FBIopeningUPP/aerix-20x20/README.md

# **AERIX**

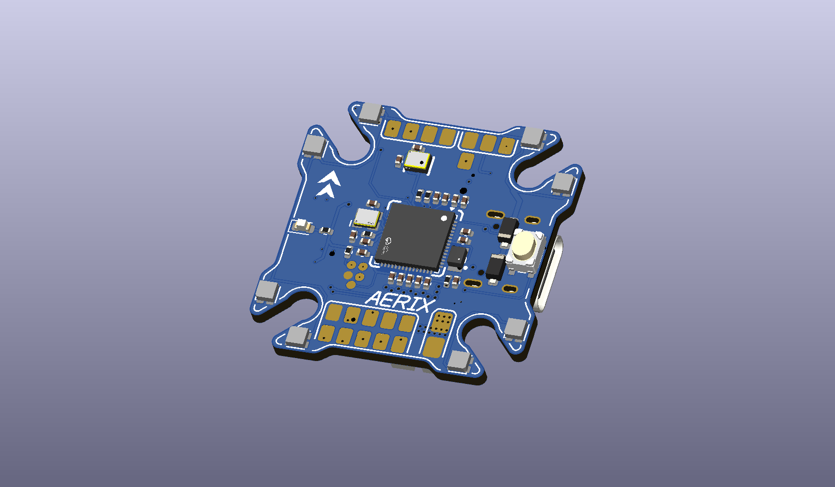
[picture p1: images/aerix-board-render.png]
AERIX 3D render


i wanted to design my own flight controller for fpv racing, so i made aerix. it fits a 20×20 mm stack and runs on an rp2354a with an icm-40609-d gyro.

i went with solder pads for the esc, receiver and vtx to keep the board small. the 8 rgb leds around the corners are there because they look cool af.

## front and back

| front | back |
| :---: | :---: |
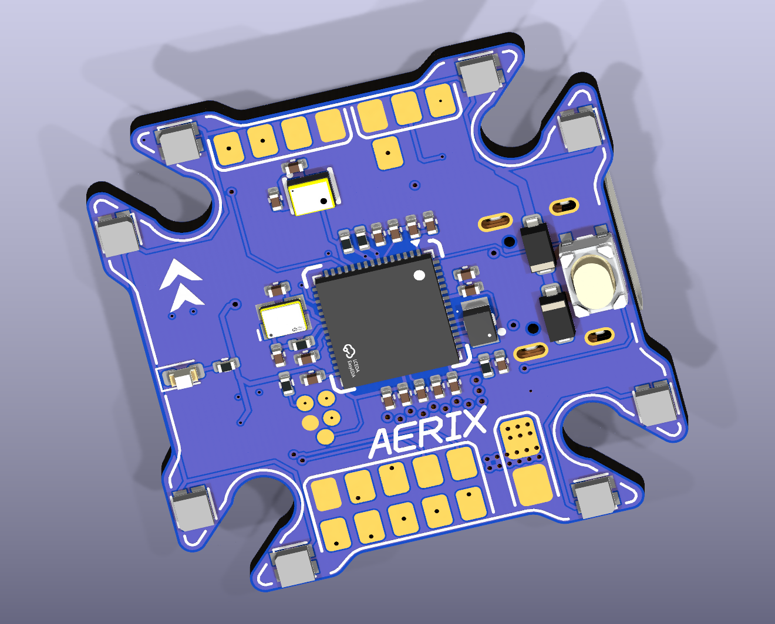
[picture p2: images/aerix-front-render.png]
Front of AERIX
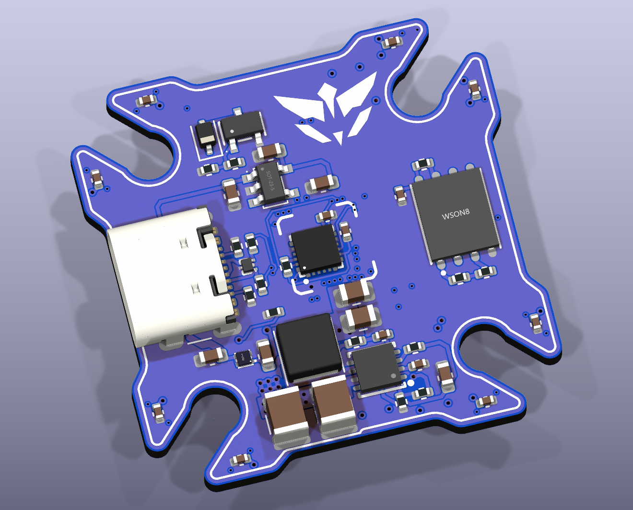
[picture p3: images/aerix-back-render.png]
Back of AERIX
|  |  |

## copper layers

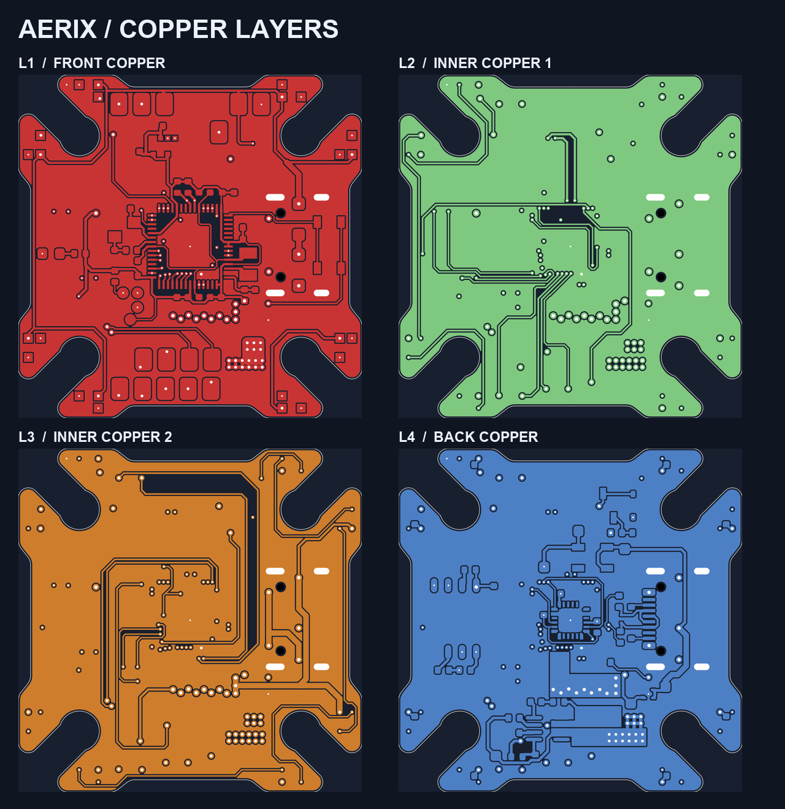
[picture p4: images/layers/aerix-copper-layers.png]
All four AERIX copper layers


<details>
<summary>see each layer up close</summary>

| front copper | inner copper 1 |
| :---: | :---: |
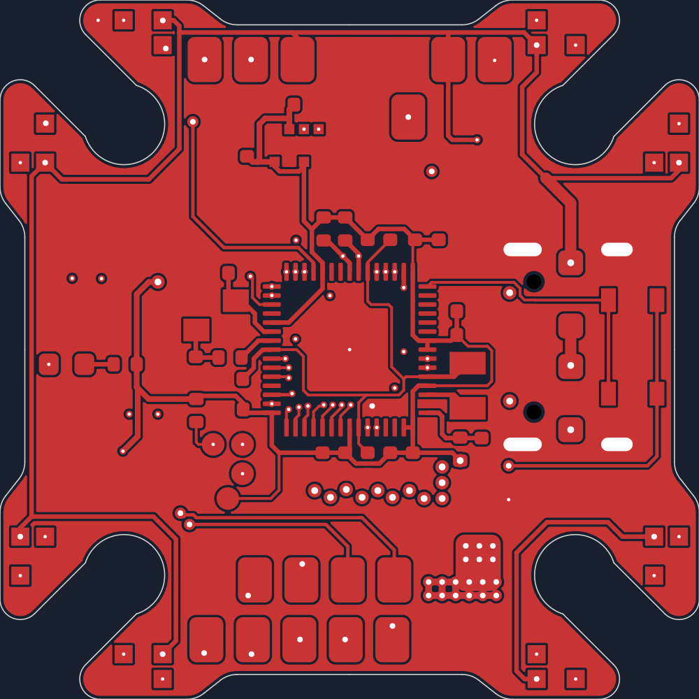
[picture p5: images/layers/01-front-copper.png]
Front copper
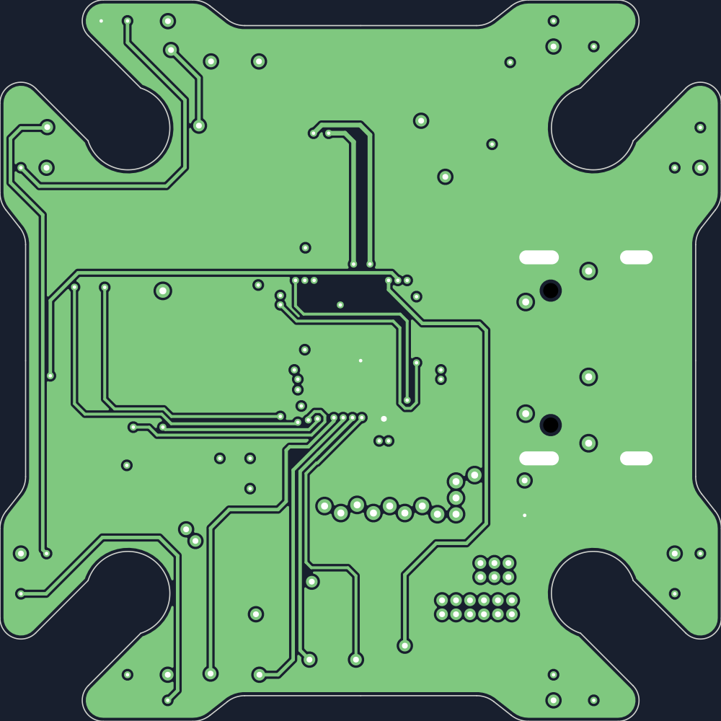
[picture p6: images/layers/02-inner-copper-1.png]
Inner copper 1
|  |  |

| inner copper 2 | back copper |
| :---: | :---: |
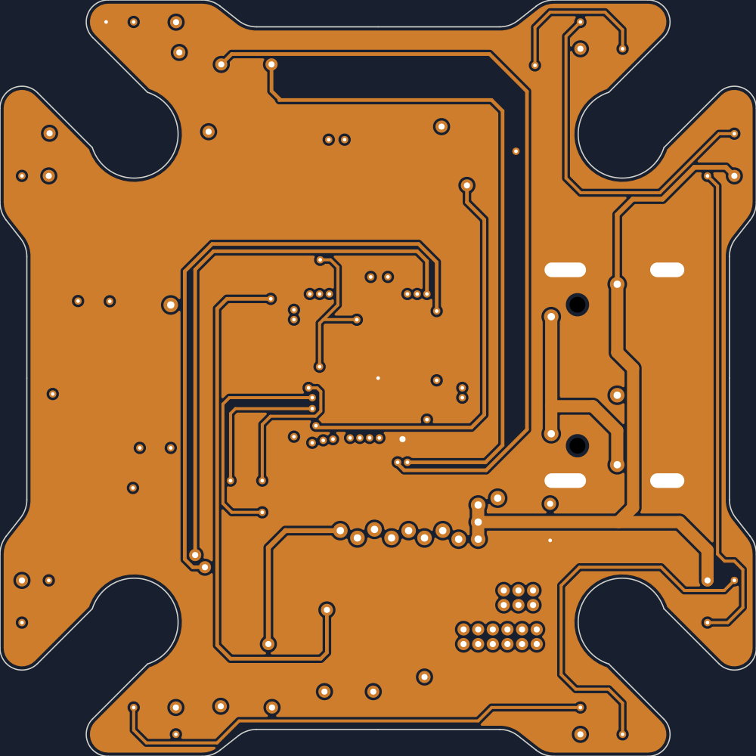
[picture p7: images/layers/03-inner-copper-2.png]
Inner copper 2
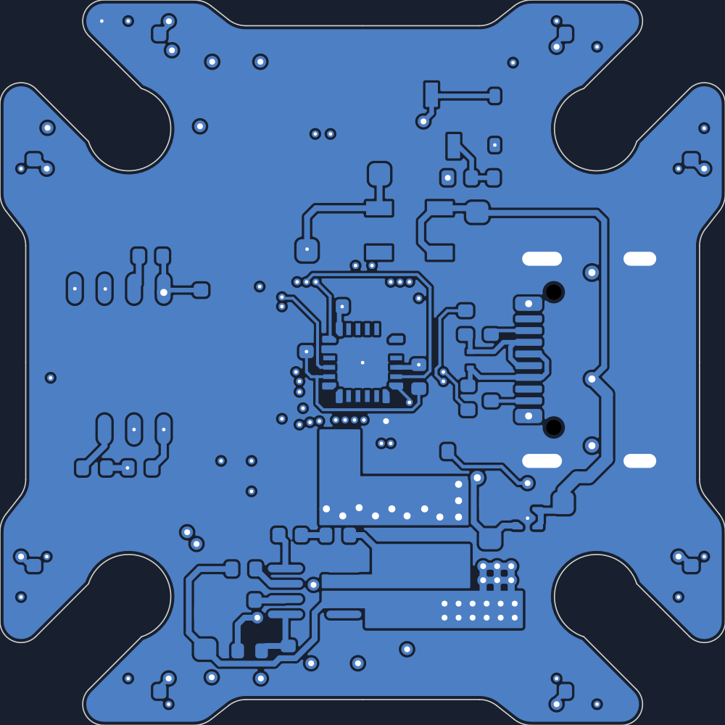
[picture p8: images/layers/04-back-copper.png]
Back copper
|  |  |

</details>

## files

- [kicad project](hardware/fc-v1/fc-v1.kicad_pro)
- [gerbers and drill files](hardware/production/fc-v1/fc-v1.zip)
- [interactive BOM](hardware/production/fc-v1/ibom.html) (download and open in a browser)

## bill of materials

| ref | part | qty |
| --- | --- | ---: |
| U1 | RP2354A microcontroller | 1 |
| U3 | ICM-40609-D gyro | 1 |
| U4 | W25Q128JVPIQTR flash | 1 |
| U5 | MP9943GQ-Z 5 V regulator | 1 |
| J1 | USB4105-GF-A USB-C port | 1 |
| LED10–LED17 | WS2812B-2020-V6 RGB LEDs | 8 |
| U2 | DPS368 barometer (optional) | 1 |

[full parts list with quantities and supplier links](hardware/production/fc-v1/aerix-bom.csv)
