FBIopeningUPP/aerix-20x20/hardware/production/fc-v1/aerix-bom.csv

Part | Quantity | References | Footprint | LCSC Part # | Supplier link | Notes
Capacitor, 4.7uF | 3 | C1, C11, C12 | 0402 |  | https://www.digikey.in/en/products/result?keywords=Capacitor%2C%204.7uF%200402
Capacitor, 0.1uF | 11 | C10, C13, C14, C2, C3, C4, C5, C6, C7, C8, C9 | 0402 |  | https://www.digikey.in/en/products/result?keywords=Capacitor%2C%200.1uF%200402
Capacitor, 10pF | 2 | C15, C16 | 0402 |  | https://www.digikey.in/en/products/result?keywords=Capacitor%2C%2010pF%200402
Capacitor, 2.2uF | 1 | C17 | 0603 |  | https://www.digikey.in/en/products/result?keywords=Capacitor%2C%202.2uF%200603
Capacitor, 100nF | 6 | C18, C20, C21, C22, C23, C24 | 0402 |  | https://www.digikey.in/en/products/result?keywords=Capacitor%2C%20100nF%200402
Capacitor, 10nF | 1 | C19 | 0402 |  | https://www.digikey.in/en/products/result?keywords=Capacitor%2C%2010nF%200402
Capacitor, 10uF 50V X7R | 2 | C25, C26 | 1210 |  | https://www.digikey.in/en/products/result?keywords=Capacitor%2C%2010uF%2050V%20X7R%201210
Capacitor, 1uF 50V | 1 | C27 | 0603 |  | https://www.digikey.in/en/products/result?keywords=Capacitor%2C%201uF%2050V%200603
Capacitor, 22uF 10V X7R | 2 | C28, C29 | 0805 |  | https://www.digikey.in/en/products/result?keywords=Capacitor%2C%2022uF%2010V%20X7R%200805
Capacitor, 2.2uF 10V | 4 | C30, C31, C32, C33 | 0603 |  | https://www.digikey.in/en/products/result?keywords=Capacitor%2C%202.2uF%2010V%200603
Capacitor, 100nF 16V X7R | 8 | C42, C43, C44, C45, C46, C47, C48, C49 | 0402 |  | https://www.digikey.in/en/products/result?keywords=Capacitor%2C%20100nF%2016V%20X7R%200402
PMEG4010CEH,115 | 2 | D1, D2 | D_SOD-123F |  | https://www.digikey.in/en/products/result?keywords=PMEG4010CEH%2C115
BAT54WS | 1 | D4 | D_SOD-323 |  | https://www.digikey.in/en/products/result?keywords=BAT54WS
TPD2EUSB30ADRTR | 1 | D5 | SOT-9X3-3_L1.0-W0.8-P0.35-LS1.0-BR | C94934 | https://www.lcsc.com/product-detail/C94934.html
USB4105-GF-A | 1 | J1 | USB_C_Receptacle_GCT_USB4105-xx-A_16P_TopMnt_Horizontal |  | https://www.digikey.in/en/products/result?keywords=USB4105-GF-A
3.3 uH inductor (AOTA-B201610S3R3-101-T) | 1 | L1 | IND-SMD_L2.0-W1.6_AOTA-B201610S3R3-101-T | C42411119 | https://www.lcsc.com/product-detail/C42411119.html
10 uH, 1 A inductor (4 x 4 x 1.8 mm) | 1 | L3 | L_APV_ANR4020 |  | https://www.digikey.in/en/products/result
LTST-C191KRKT | 1 | LED1 | 0603 |  | https://www.digikey.in/en/products/result?keywords=LTST-C191KRKT
WS2812B-2020-V6 | 8 | LED10, LED11, LED12, LED13, LED14, LED15, LED16, LED17 | LED-SMD_4P-L2.2-W2.0-P1.00_WS2815C-2020-4P | C52917434 | https://www.lcsc.com/product-detail/C52917434.html
2N7002BK,215 | 1 | Q1 | SOT-23-3_L3.0-W1.7-P0.95-LS2.9-BR | C282405 | https://www.lcsc.com/product-detail/C282405.html
Resistor, 33 ohm | 1 | R1 | 0402 |  | https://www.digikey.in/en/products/result?keywords=Resistor%2C%2033%20ohm%200402
Resistor, 100R | 1 | R19 | 0402 |  | https://www.digikey.in/en/products/result?keywords=Resistor%2C%20100R%200402
Resistor, 1k | 2 | R2, R3 | 0402 |  | https://www.digikey.in/en/products/result?keywords=Resistor%2C%201k%200402
Resistor, 100k | 1 | R20 | 0402 |  | https://www.digikey.in/en/products/result?keywords=Resistor%2C%20100k%200402
Resistor, 5.1k 1% | 2 | R21, R22 | 0402 |  | https://www.digikey.in/en/products/result?keywords=Resistor%2C%205.1k%201%25%200402
Resistor, 27R | 2 | R23, R24 | 0402 |  | https://www.digikey.in/en/products/result?keywords=Resistor%2C%2027R%200402
Resistor, 10k | 5 | R25, R28, R29, R30, R31 | 0402 |  | https://www.digikey.in/en/products/result?keywords=Resistor%2C%2010k%200402
Resistor, 330R | 1 | R32 | 0402 |  | https://www.digikey.in/en/products/result?keywords=Resistor%2C%20330R%200402
Resistor, 4.7k | 2 | R4, R5 | 0402 |  | https://www.digikey.in/en/products/result?keywords=Resistor%2C%204.7k%200402
Resistor, 1M | 1 | R6 | 0402 |  | https://www.digikey.in/en/products/result?keywords=Resistor%2C%201M%200402
Resistor, 52.3k 1% | 1 | R7 | 0402 |  | https://www.digikey.in/en/products/result?keywords=Resistor%2C%2052.3k%201%25%200402
Resistor, 10k 1% | 1 | R8 | 0402 |  | https://www.digikey.in/en/products/result?keywords=Resistor%2C%2010k%201%25%200402
Resistor, 20R | 1 | R9 | 0402 |  | https://www.digikey.in/en/products/result?keywords=Resistor%2C%2020R%200402
Momentary SMD push button (4.2 x 3.2 x 2.5 mm) | 1 | SW1 | Push_SMD_4.2x3.2mm_h2.5mm_Beige |  | https://www.digikey.in/en/products/result
RP2354A | 1 | U1 | QFN-60-1EP_7x7mm_P0.4mm_EP3.4x3.4mm |  | https://www.digikey.in/en/products/result?keywords=RP2354A
DPS368XTSA1 | 1 | U2 | LGA-8_L2.5-W2.0-P0.65-TR_DPS368 | C3232508 | https://www.lcsc.com/product-detail/C3232508.html | Optional barometer
ICM-40609-D | 1 | U3 | LGA-24_L3.0-W3.0-P0.40-TL | C5360621 | https://www.lcsc.com/product-detail/C5360621.html
W25Q128JVPIQTR | 1 | U4 | WSON-8_L6.0-W5.0-P1.27-BL-EP | C190862 | https://www.lcsc.com/product-detail/C190862.html
MP9943GQ-Z | 1 | U5 | QFN-8_L3.0-W3.0-P0.65-BL | C477821 | https://www.lcsc.com/product-detail/C477821.html
TLV75533PDQNR | 1 | U6 | X2SON-4_L1.0-W1.0-P0.65-TL-EP | C2861882 | https://www.lcsc.com/product-detail/C2861882.html
LP5907MFX-3.3/NOPB | 1 | U7 | SOT-23-5_L3.0-W1.7-P0.95-LS2.8-BR | C80670 | https://www.lcsc.com/product-detail/C80670.html
ABM10-167-12.000MHZ-T3 | 1 | X1 | CRYSTAL-SMD_4P-L2.5-W2.0-BL | C1985295 | https://www.lcsc.com/product-detail/C1985295.html
