FBIopeningUPP/aerix-20x20/hardware/production/fc-v1/bom.csv

Designator | Footprint | Quantity | Value | LCSC Part #
C1, C11, C12 | 0402 | 3 | 4.7uF
C10, C13, C14, C2, C3, C4, C5, C6, C7, C8, C9 | 0402 | 11 | 0.1uF
C15, C16 | 0402 | 2 | 10pF
C17 | 0603 | 1 | 2.2uF
C18, C20, C21, C22, C23, C24 | 0402 | 6 | 100nF
C19 | 0402 | 1 | 10nF
C25, C26 | 1210 | 2 | 10uF 50V X7R
C27 | 0603 | 1 | 1uF 50V
C28, C29 | 0805 | 2 | 22uF 10V X7R
C30, C31, C32, C33 | 0603 | 4 | 2.2uF 10V
C42, C43, C44, C45, C46, C47, C48, C49 | 0402 | 8 | 100nF 16V X7R
D1, D2 | D_SOD-123F | 2 | PMEG4010CEH,115
D4 | D_SOD-323 | 1 | BAT54WS
D5 | SOT-9X3-3_L1.0-W0.8-P0.35-LS1.0-BR | 1 | TPD2EUSB30ADRTR | C94934
J1 | USB_C_Receptacle_GCT_USB4105-xx-A_16P_TopMnt_Horizontal | 1 | USB4105-GF-A
L1 | IND-SMD_L2.0-W1.6_AOTA-B201610S3R3-101-T | 1 | 3.3uH | C42411119
L3 | L_APV_ANR4020 | 1 | 10uH_1.0A_4018
LED1 | 0603 | 1 | LTST-C191KRKT
LED10, LED11, LED12, LED13, LED14, LED15, LED16, LED17 | LED-SMD_4P-L2.2-W2.0-P1.00_WS2815C-2020-4P | 8 | WS2812B-2020-V6 | C52917434
Q1 | SOT-23-3_L3.0-W1.7-P0.95-LS2.9-BR | 1 | 2N7002BK,215 | C282405
R1 | 0402 | 1 | 33
R19 | 0402 | 1 | 100R
R2, R3 | 0402 | 2 | 1k
R20 | 0402 | 1 | 100k
R21, R22 | 0402 | 2 | 5.1k 1%
R23, R24 | 0402 | 2 | 27R
R25, R28, R29, R30, R31 | 0402 | 5 | 10k
R32 | 0402 | 1 | 330R
R4, R5 | 0402 | 2 | 4.7k
R6 | 0402 | 1 | 1M
R7 | 0402 | 1 | 52.3k 1%
R8 | 0402 | 1 | 10k 1%
R9 | 0402 | 1 | 20R
SW1 | Push_SMD_4.2x3.2mm_h2.5mm_Beige | 1 | Momentary Tactile Button - Biege
U1 | QFN-60-1EP_7x7mm_P0.4mm_EP3.4x3.4mm | 1 | RP2354A
U2 | LGA-8_L2.5-W2.0-P0.65-TR_DPS368 | 1 | DPS368XTSA1 | C3232508
U3 | LGA-24_L3.0-W3.0-P0.40-TL | 1 | ICM-40609-D | C5360621
U4 | WSON-8_L6.0-W5.0-P1.27-BL-EP | 1 | W25Q128JVPIQTR | C190862
U5 | QFN-8_L3.0-W3.0-P0.65-BL | 1 | MP9943GQ-Z | C477821
U6 | X2SON-4_L1.0-W1.0-P0.65-TL-EP | 1 | TLV75533PDQNR | C2861882
U7 | SOT-23-5_L3.0-W1.7-P0.95-LS2.8-BR | 1 | LP5907MFX-3.3/NOPB | C80670
X1 | CRYSTAL-SMD_4P-L2.5-W2.0-BL | 1 | ABM10-167-12.000MHZ-T3 | C1985295
