FBIopeningUPP/aerix-20x20/hardware/fc-v1/fc-v1.kicad_pcb

## KiCad design hardware/fc-v1/fc-v1.kicad_pcb (2026-11-10)

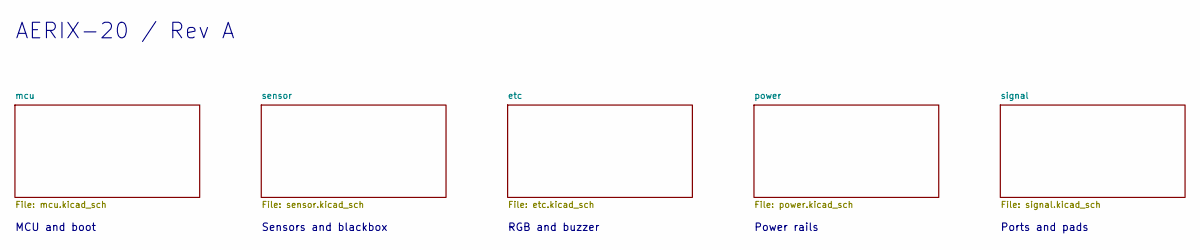
[picture p9: schematic fc-v1.kicad_sch, AERIX-20 - Flight controller]

Notes on the sheet:
Ports and pads
Sensors and blackbox
RGB and buzzer
AERIX-20 / Rev A
MCU and boot
Power rails

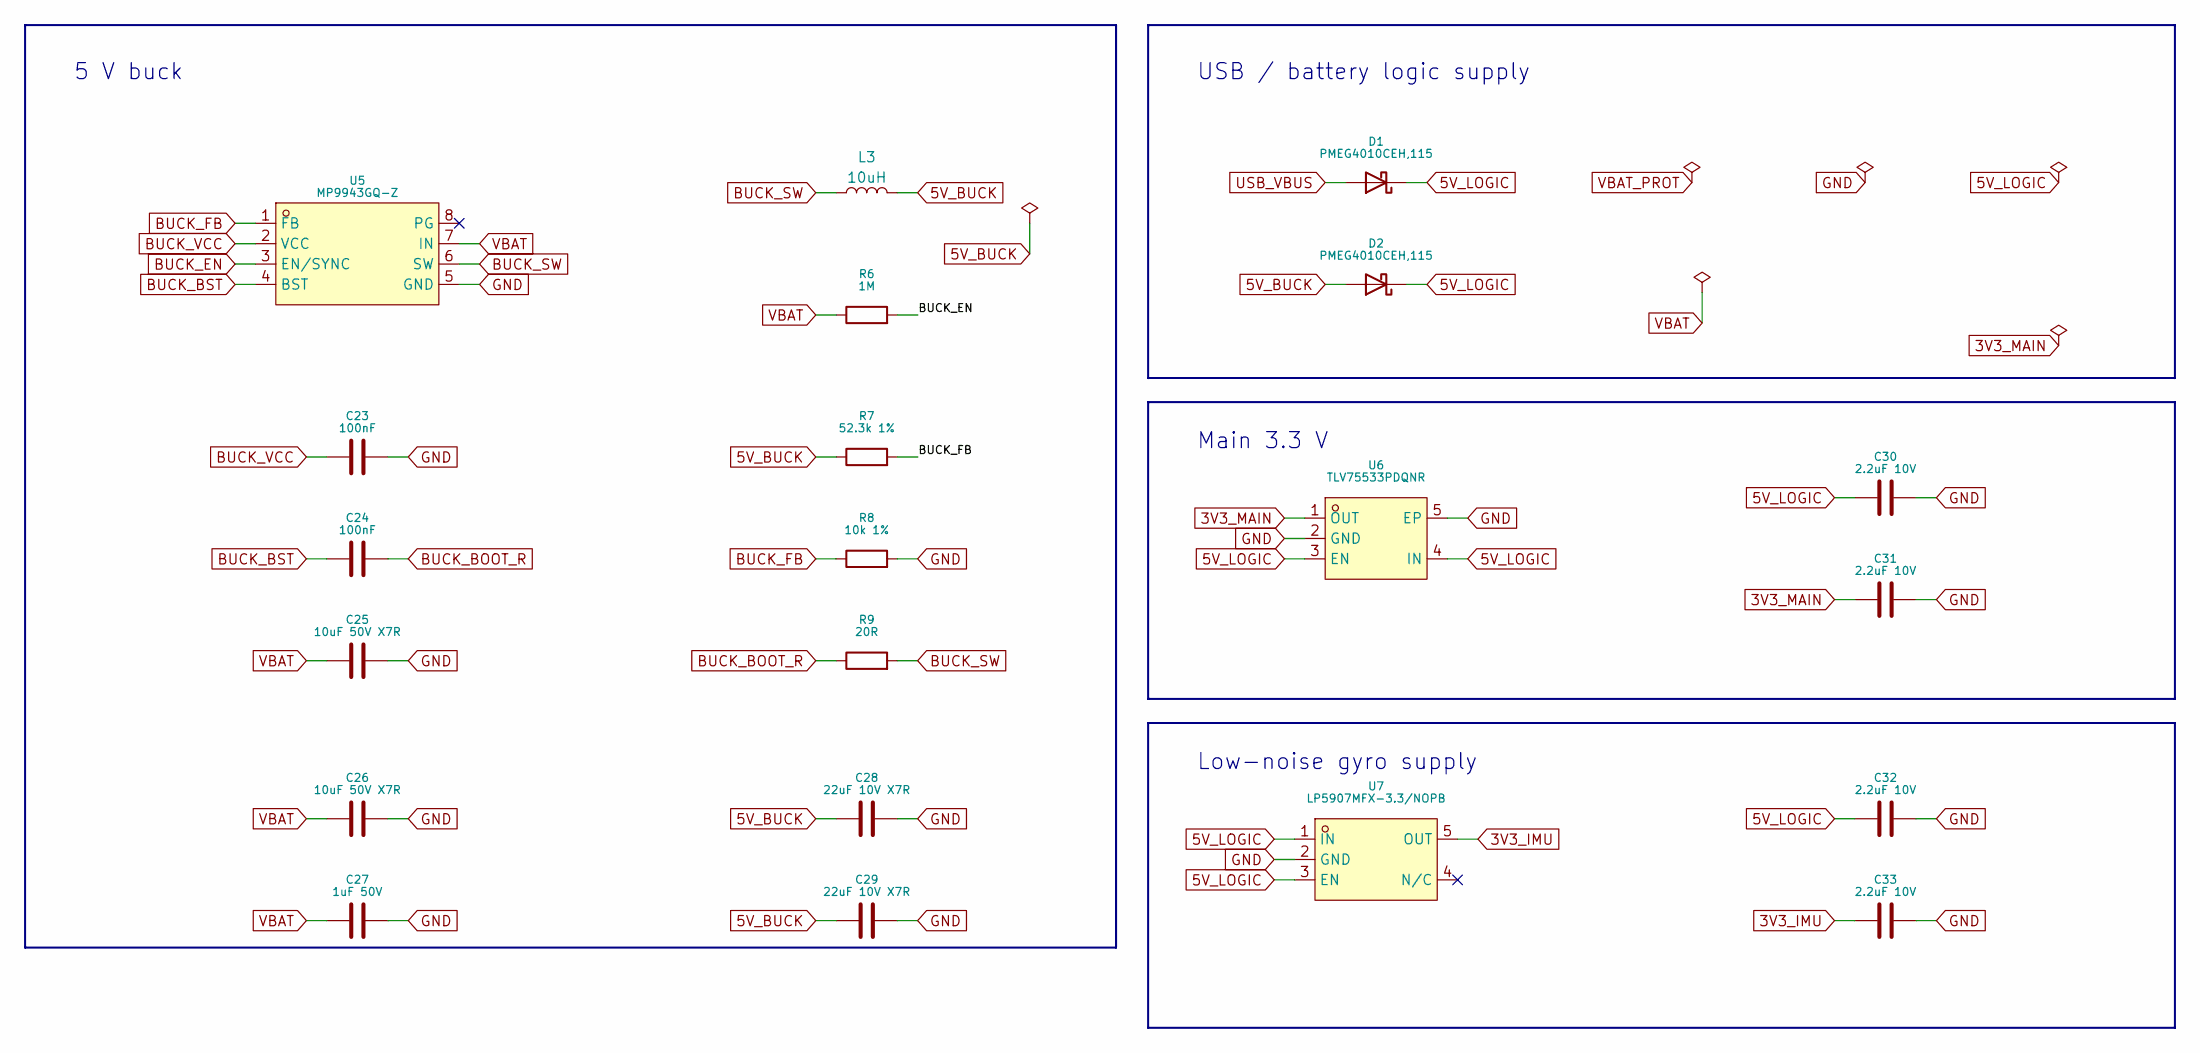
[picture p10: schematic power.kicad_sch, AERIX-20 - Battery input and power rails]

Parts:
C23, C24: 100nF; C_0402_1005Metric
C25, C26: 10uF 50V X7R; C_1210_3225Metric
C27: 1uF 50V; C_0603_1608Metric
C28, C29: 22uF 10V X7R; C_0805_2012Metric
C30, C31, C32, C33: 2.2uF 10V; C_0603_1608Metric
D1, D2: PMEG4010CEH,115; D_SOD-123F
L3: 10uH_1.0A_4018; L_APV_ANR4020; Part Number NRS4018T100MDGJ
R6: 1M; R_0402_1005Metric
R7: 52.3k 1%; R_0402_1005Metric
R8: 10k 1%; R_0402_1005Metric
R9: 20R; R_0402_1005Metric
U5: MP9943GQ-Z; QFN-8_L3.0-W3.0-P0.65-BL
U6: TLV75533PDQNR; X2SON-4_L1.0-W1.0-P0.65-TL-EP
U7: LP5907MFX-3.3/NOPB; SOT-23-5_L3.0-W1.7-P0.95-LS2.8-BR

Connections:
3V3_IMU: C33.1, U7.5 (OUT); also elsewhere on the board
3V3_MAIN: C31.1, U6.1 (OUT); also elsewhere on the board
5V_BUCK: C28.1, C29.1, D2.2 (A), L3.2, R7.1; also elsewhere on the board
5V_LOGIC: C30.1, C32.1, D1.1 (K), D2.1 (K), U6.3 (EN), U6.4 (IN), U7.1 (IN), U7.3 (EN)
BUCK_BOOT_R: C24.2, R9.1
BUCK_BST: C24.1, U5.4 (BST)
BUCK_EN: R6.2, U5.3 (EN/SYNC)
BUCK_FB: R7.2, R8.1, U5.1 (FB)
BUCK_SW: L3.1, R9.2, U5.6 (SW)
BUCK_VCC: C23.1, U5.2 (VCC)
GND: C23.2, C25.2, C26.2, C27.2, C28.2, C29.2, C30.2, C31.2, C32.2, C33.2, R8.2, U5.5 (GND), U6.2 (GND), U6.5 (EP), U7.2 (GND); also elsewhere on the board
USB_VBUS: D1.2 (A); also elsewhere on the board
VBAT: C25.1, C26.1, C27.1, R6.1, U5.7 (IN); also elsewhere on the board

Notes on the sheet:
5 V buck
USB / battery logic supply
Main 3.3 V
Low-noise gyro supply

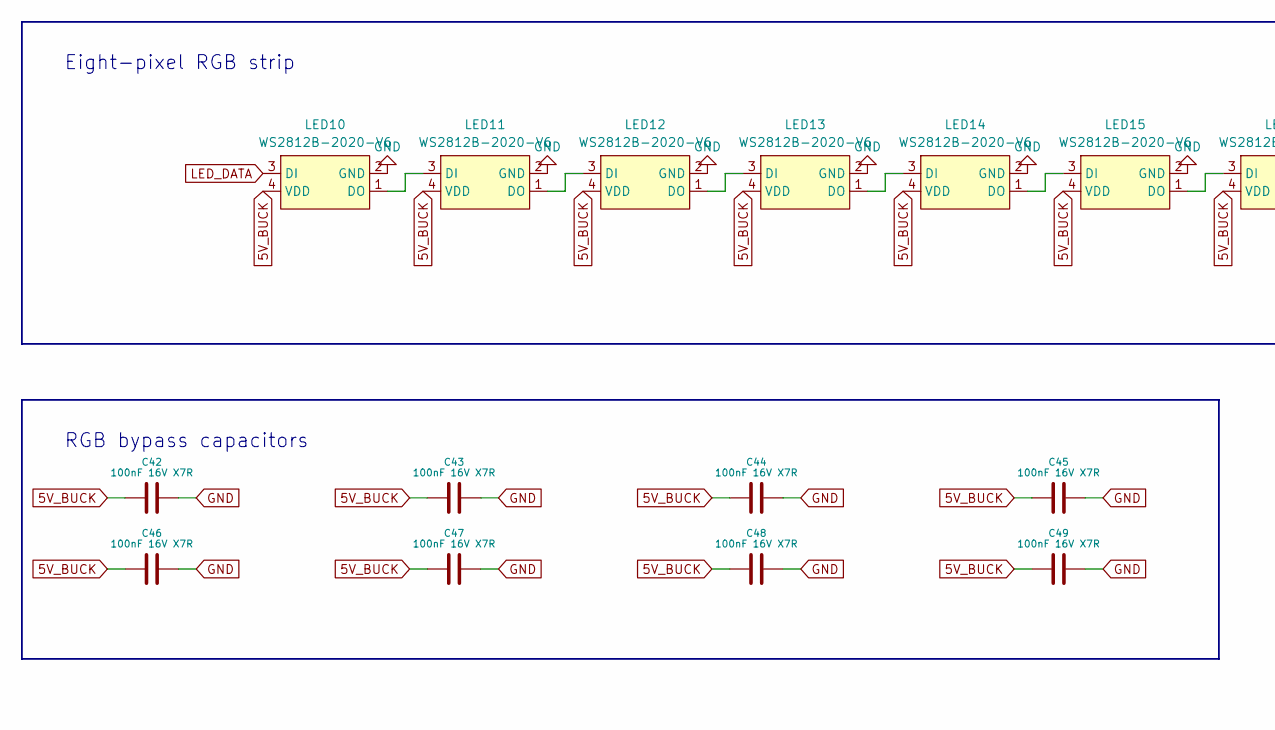
[picture p11: schematic etc.kicad_sch, AERIX-20 - RGB, status LED and buzzer, part in row 1, column 1]

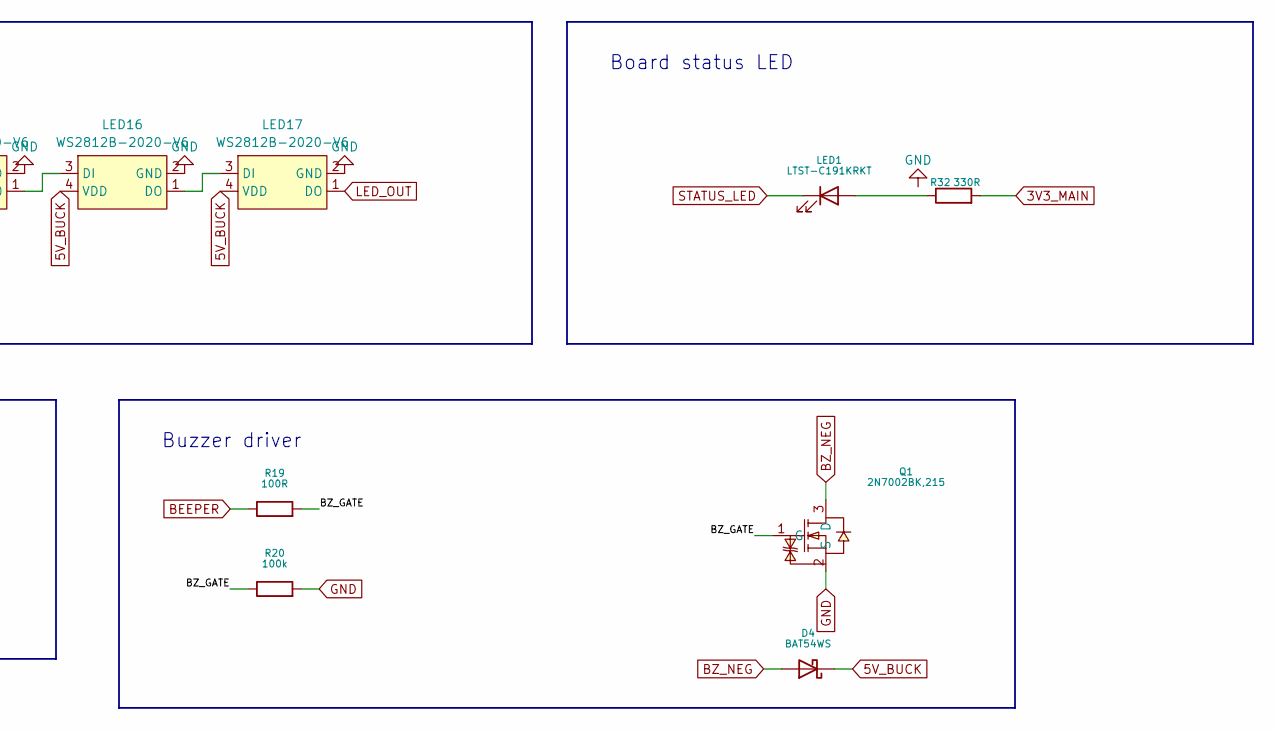
[picture p12: schematic etc.kicad_sch, AERIX-20 - RGB, status LED and buzzer, part in row 1, column 2]

Parts:
C42, C43, C44, C45, C46, C47, C48, C49: 100nF 16V X7R; C_0402_1005Metric
D4: BAT54WS; D_SOD-323
LED1: LTST-C191KRKT; LED_0603_1608Metric
LED10, LED11, LED12, LED13, LED14, LED15, LED16, LED17: WS2812B-2020-V6; LED-SMD_4P-L2.2-W2.0-P1.00_WS2815C-2020-4P; MPN WS2812B-2020-V6; LCSC Part C52917434
Q1: 2N7002BK,215; SOT-23-3_L3.0-W1.7-P0.95-LS2.9-BR
R19: 100R; R_0402_1005Metric
R20: 100k; R_0402_1005Metric
R32: 330R; R_0402_1005Metric

Connections:
3V3_MAIN: R32.2; also elsewhere on the board
5V_BUCK: C42.1, C43.1, C44.1, C45.1, C46.1, C47.1, C48.1, C49.1, D4.1 (K), LED10.4 (VDD), LED11.4 (VDD), LED12.4 (VDD), LED13.4 (VDD), LED14.4 (VDD), LED15.4 (VDD), LED16.4 (VDD), LED17.4 (VDD); also elsewhere on the board
/etc/BZ_GATE: Q1.1 (G), R19.2, R20.1
BEEPER: R19.1; also elsewhere on the board
BZ_NEG: D4.2 (A), Q1.3 (D); also elsewhere on the board
GND: C42.2, C43.2, C44.2, C45.2, C46.2, C47.2, C48.2, C49.2, LED10.2 (GND), LED11.2 (GND), LED12.2 (GND), LED13.2 (GND), LED14.2 (GND), LED15.2 (GND), LED16.2 (GND), LED17.2 (GND), Q1.2 (S), R20.2; also elsewhere on the board
LED_DATA: LED10.3 (DI); also elsewhere on the board
LED_OUT: LED17.1 (DO); also elsewhere on the board
unnamed: LED1.2 (A), R32.1
unnamed: LED10.1 (DO), LED11.3 (DI)
unnamed: LED11.1 (DO), LED12.3 (DI)
unnamed: LED12.1 (DO), LED13.3 (DI)
unnamed: LED13.1 (DO), LED14.3 (DI)
unnamed: LED14.1 (DO), LED15.3 (DI)
unnamed: LED15.1 (DO), LED16.3 (DI)
unnamed: LED16.1 (DO), LED17.3 (DI)
STATUS_LED: LED1.1 (K); also elsewhere on the board

Notes on the sheet:
RGB bypass capacitors
Eight-pixel RGB strip
Board status LED
Buzzer driver

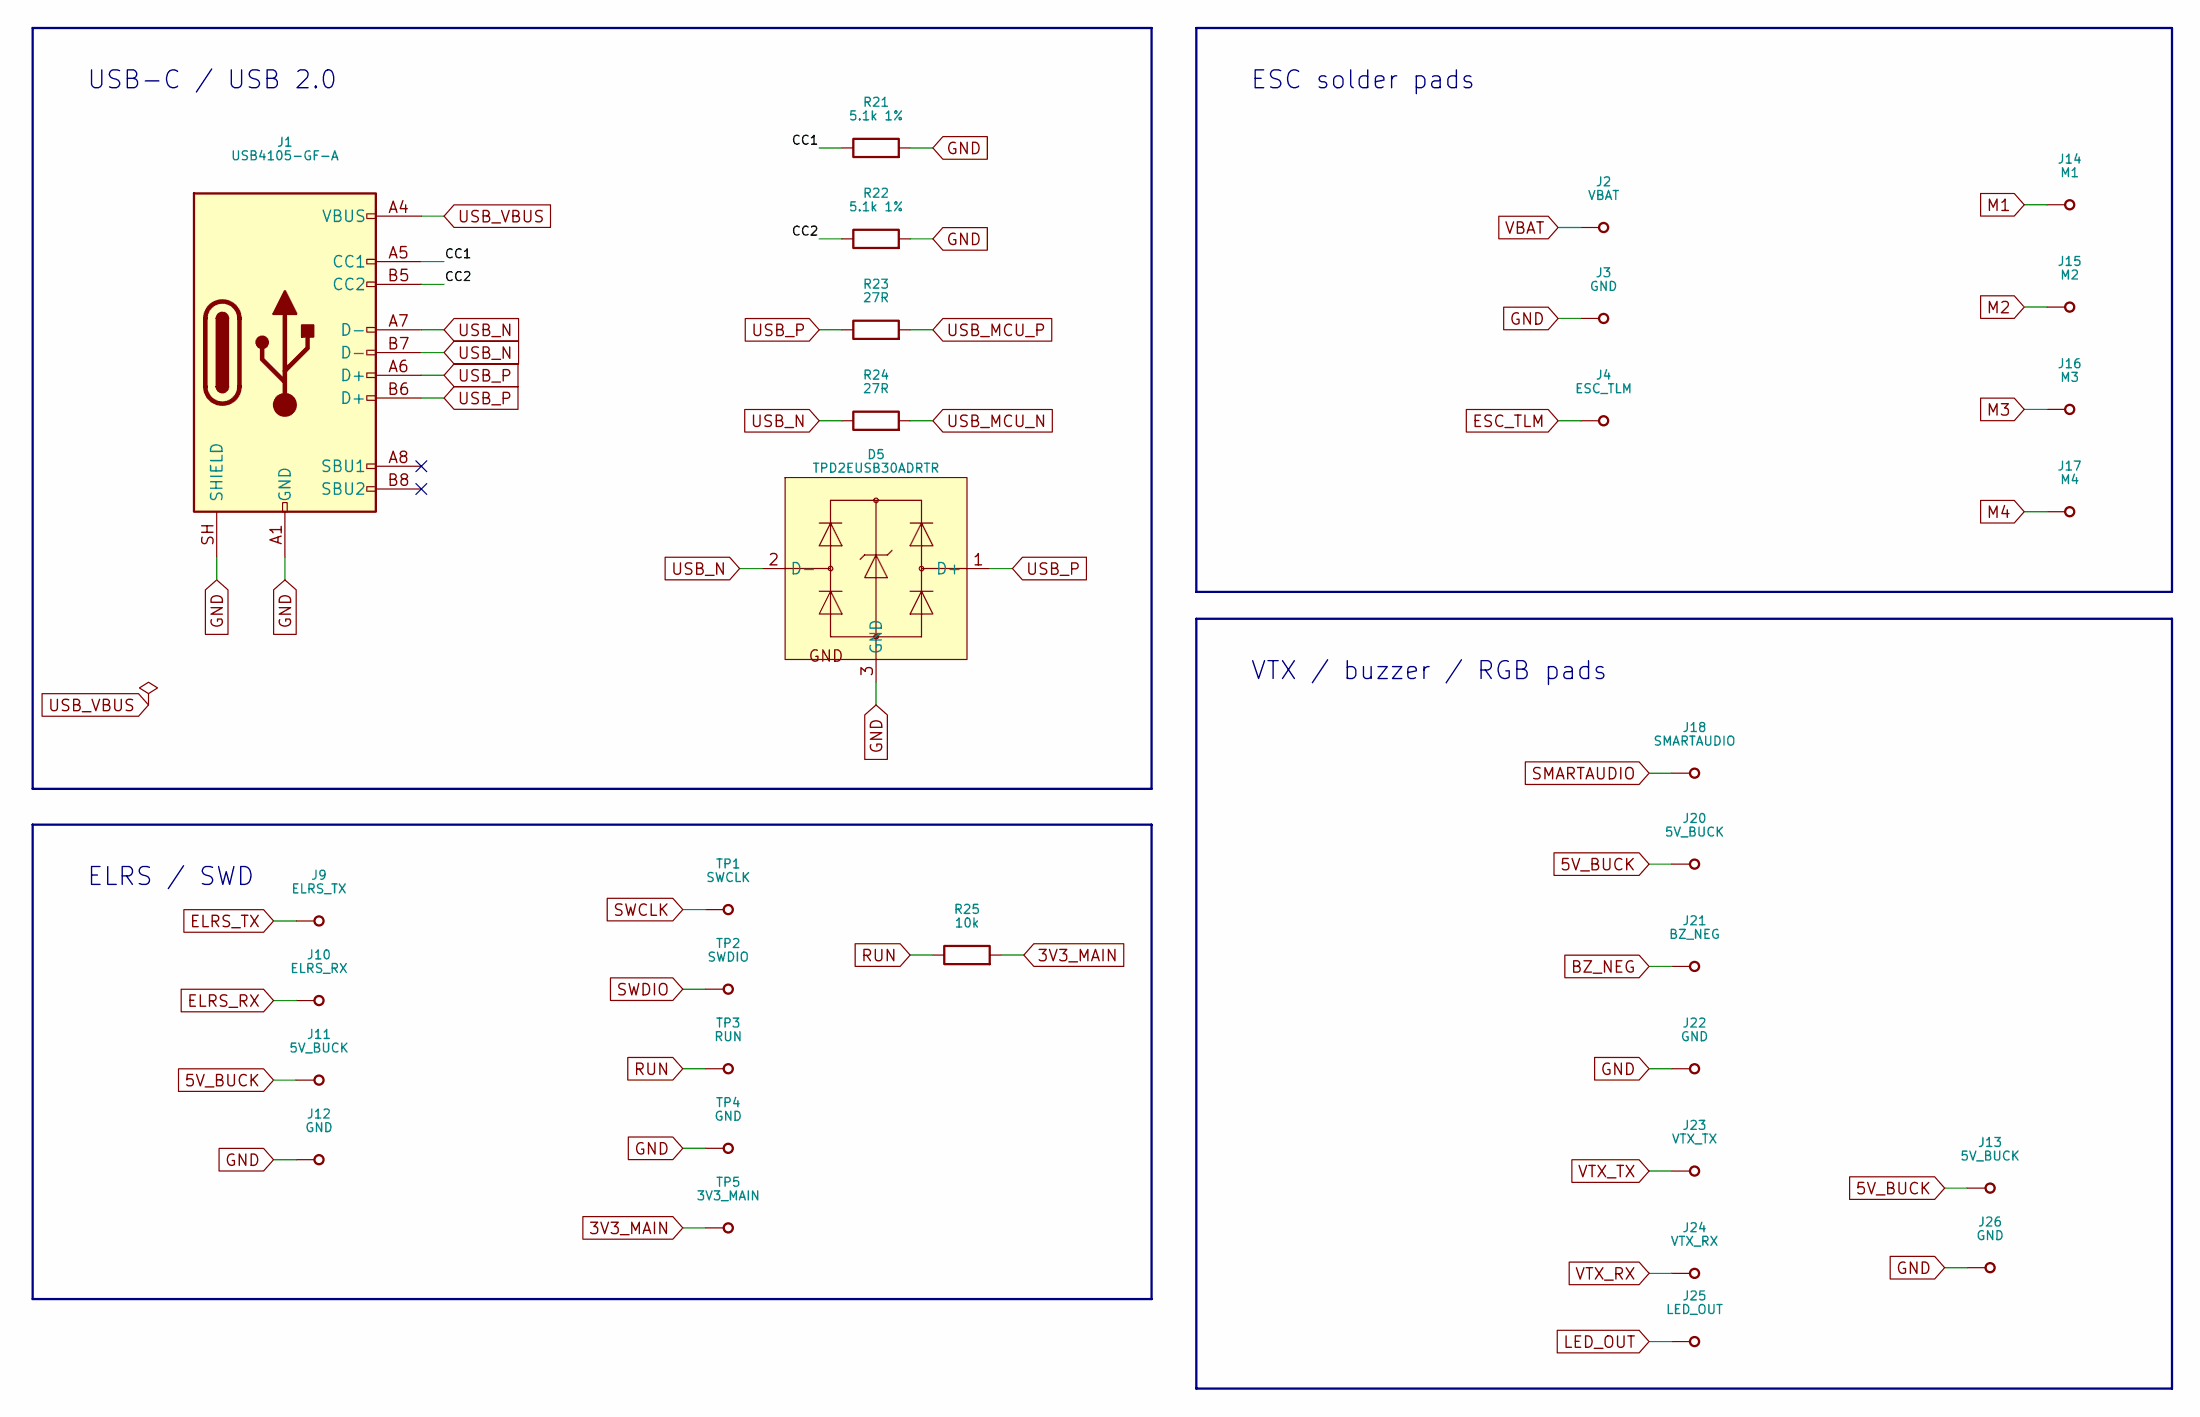
[picture p13: schematic signal.kicad_sch, AERIX-20 - External connectors and solder pads]

Parts:
D5: TPD2EUSB30ADRTR; SOT-9X3-3_L1.0-W0.8-P0.35-LS1.0-BR
J1: USB4105-GF-A; USB_C_Receptacle_GCT_USB4105-xx-A_16P_TopMnt_Horizontal
J2: VBAT; WirePad_2.0x2.5mm
J3: GND; WirePad_2.0x2.5mm
J4: ESC_TLM; WirePad_1.5x2.0mm
J9: ELRS_TX; WirePad_1.5x2.0mm
J10: ELRS_RX; WirePad_1.5x2.0mm
J11, J13, J20: 5V_BUCK; WirePad_1.5x2.0mm
J12, J22, J26: GND; WirePad_1.5x2.0mm
J14: M1; WirePad_1.5x2.0mm
J15: M2; WirePad_1.5x2.0mm
J16: M3; WirePad_1.5x2.0mm
J17: M4; WirePad_1.5x2.0mm
J18: SMARTAUDIO; WirePad_1.5x2.0mm
J21: BZ_NEG; WirePad_1.5x2.0mm
J23: VTX_TX; WirePad_1.5x2.0mm
J24: VTX_RX; WirePad_1.5x2.0mm
J25: LED_OUT; WirePad_1.5x2.0mm
R21, R22: 5.1k 1%; R_0402_1005Metric
R23, R24: 27R; R_0402_1005Metric
R25: 10k; R_0402_1005Metric
TP1: SWCLK; ProbePad_D1.0mm
TP2: SWDIO; ProbePad_D1.0mm
TP3: RUN; ProbePad_D1.0mm
TP4: GND; ProbePad_D1.0mm
TP5: 3V3_MAIN; ProbePad_D1.0mm

Connections:
3V3_MAIN: R25.2, TP5.1 (~_1); also elsewhere on the board
5V_BUCK: J11.1 (~_1), J13.1 (~_1), J20.1 (~_1); also elsewhere on the board
/signal/CC1: J1.A5 (CC1), R21.1
/signal/CC2: J1.B5 (CC2), R22.1
BZ_NEG: J21.1 (~_1); also elsewhere on the board
ELRS_RX: J10.1 (~_1); also elsewhere on the board
ELRS_TX: J9.1 (~_1); also elsewhere on the board
ESC_TLM: J4.1 (~_1); also elsewhere on the board
GND: D5.3 (GND), J1.A1 (GND), J1.A12 (GND), J1.B1 (GND), J1.B12 (GND), J1.SH (SHIELD), J3.1 (~_1), J12.1 (~_1), J22.1 (~_1), J26.1 (~_1), R21.2, R22.2, TP4.1 (~_1); also elsewhere on the board
LED_OUT: J25.1 (~_1); also elsewhere on the board
M1: J14.1 (~_1); also elsewhere on the board
M2: J15.1 (~_1); also elsewhere on the board
M3: J16.1 (~_1); also elsewhere on the board
M4: J17.1 (~_1); also elsewhere on the board
RUN: R25.1, TP3.1 (~_1); also elsewhere on the board
SMARTAUDIO: J18.1 (~_1); also elsewhere on the board
SWCLK: TP1.1 (~_1); also elsewhere on the board
SWDIO: TP2.1 (~_1); also elsewhere on the board
USB_MCU_N: R24.2; also elsewhere on the board
USB_MCU_P: R23.2; also elsewhere on the board
USB_N: D5.2 (D-), J1.A7 (D-), J1.B7 (D-), R24.1
USB_P: D5.1 (D+), J1.A6 (D+), J1.B6 (D+), R23.1
USB_VBUS: J1.A4 (VBUS), J1.A9 (VBUS), J1.B4 (VBUS), J1.B9 (VBUS); also elsewhere on the board
VBAT: J2.1 (~_1); also elsewhere on the board
VTX_RX: J24.1 (~_1); also elsewhere on the board
VTX_TX: J23.1 (~_1); also elsewhere on the board

Notes on the sheet:
VTX / buzzer / RGB pads
ESC solder pads
USB-C / USB 2.0
ELRS / SWD

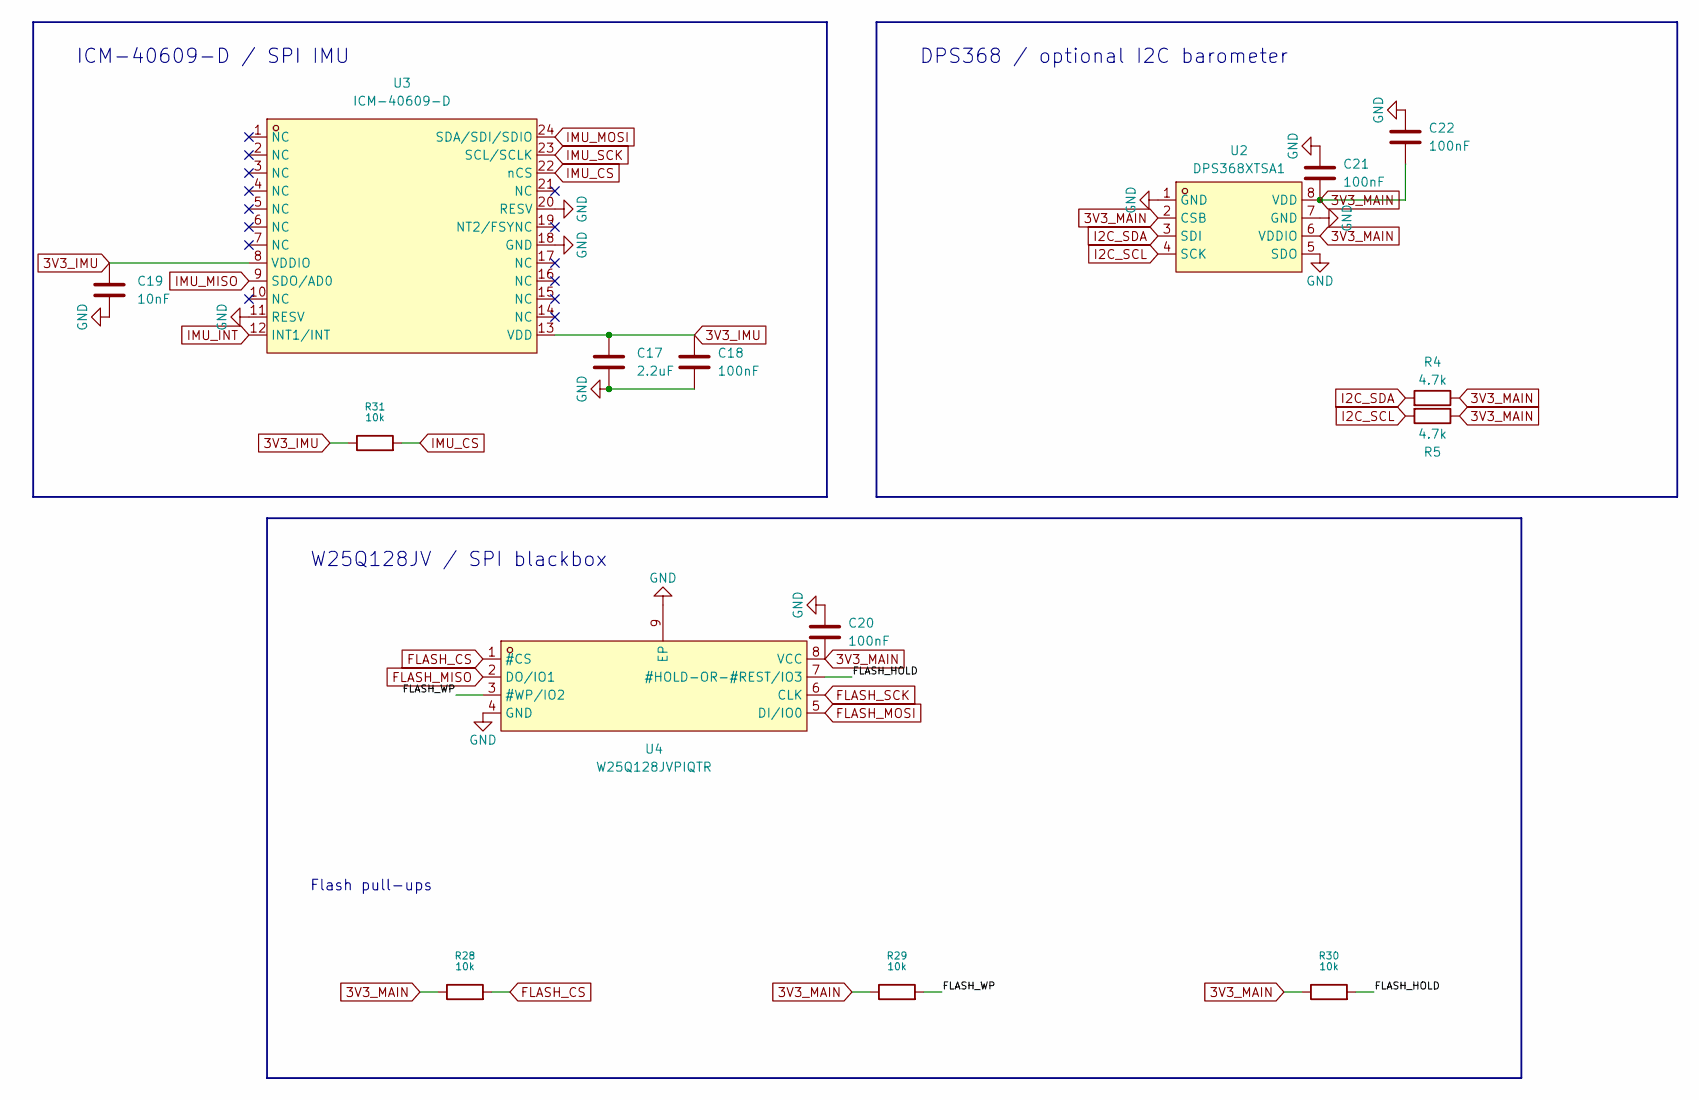
[picture p14: schematic sensor.kicad_sch, AERIX-20 - IMU, barometer and blackbox]

Parts:
C17: 2.2uF; C_0603_1608Metric
C18, C20, C21, C22: 100nF; C_0402_1005Metric
C19: 10nF; C_0402_1005Metric
R4, R5: 4.7k; R_0402_1005Metric
R28, R29, R30, R31: 10k; R_0402_1005Metric
U2: DPS368XTSA1; LGA-8_L2.5-W2.0-P0.65-TR_DPS368; MPN DPS368XTSA1; LCSC Part C3232508
U3: ICM-40609-D; LGA-24_L3.0-W3.0-P0.40-TL; MPN ICM-40609-D; LCSC Part C5360621
U4: W25Q128JVPIQTR; WSON-8_L6.0-W5.0-P1.27-BL-EP; MPN W25Q128JVPIQ; LCSC Part C190862

Connections:
3V3_IMU: C17.1, C18.1, C19.1, R31.1, U3.8 (VDDIO), U3.13 (VDD); also elsewhere on the board
3V3_MAIN: C20.2, C21.2, C22.2, R4.2, R5.2, R28.1, R29.1, R30.1, U2.2 (CSB), U2.6 (VDDIO), U2.8 (VDD), U4.8 (VCC); also elsewhere on the board
/sensor/FLASH_HOLD: R30.2, U4.7 (#HOLD-OR-#REST/IO3)
/sensor/FLASH_WP: R29.2, U4.3 (#WP/IO2)
FLASH_CS: R28.2, U4.1 (#CS); also elsewhere on the board
FLASH_MISO: U4.2 (DO/IO1); also elsewhere on the board
FLASH_MOSI: U4.5 (DI/IO0); also elsewhere on the board
FLASH_SCK: U4.6 (CLK); also elsewhere on the board
GND: C17.2, C18.2, C19.2, C20.1, C21.1, C22.1, U2.1 (GND), U2.5 (SDO), U2.7 (GND), U3.11 (RESV), U3.18 (GND), U3.20 (RESV), U4.4 (GND), U4.9 (EP); also elsewhere on the board
I2C_SCL: R5.1, U2.4 (SCK); also elsewhere on the board
I2C_SDA: R4.1, U2.3 (SDI); also elsewhere on the board
IMU_CS: R31.2, U3.22 (nCS); also elsewhere on the board
IMU_INT: U3.12 (INT1/INT); also elsewhere on the board
IMU_MISO: U3.9 (SDO/AD0); also elsewhere on the board
IMU_MOSI: U3.24 (SDA/SDI/SDIO); also elsewhere on the board
IMU_SCK: U3.23 (SCL/SCLK); also elsewhere on the board

Notes on the sheet:
ICM-40609-D / SPI IMU
DPS368 / optional I2C barometer
Flash pull-ups
W25Q128JV / SPI blackbox

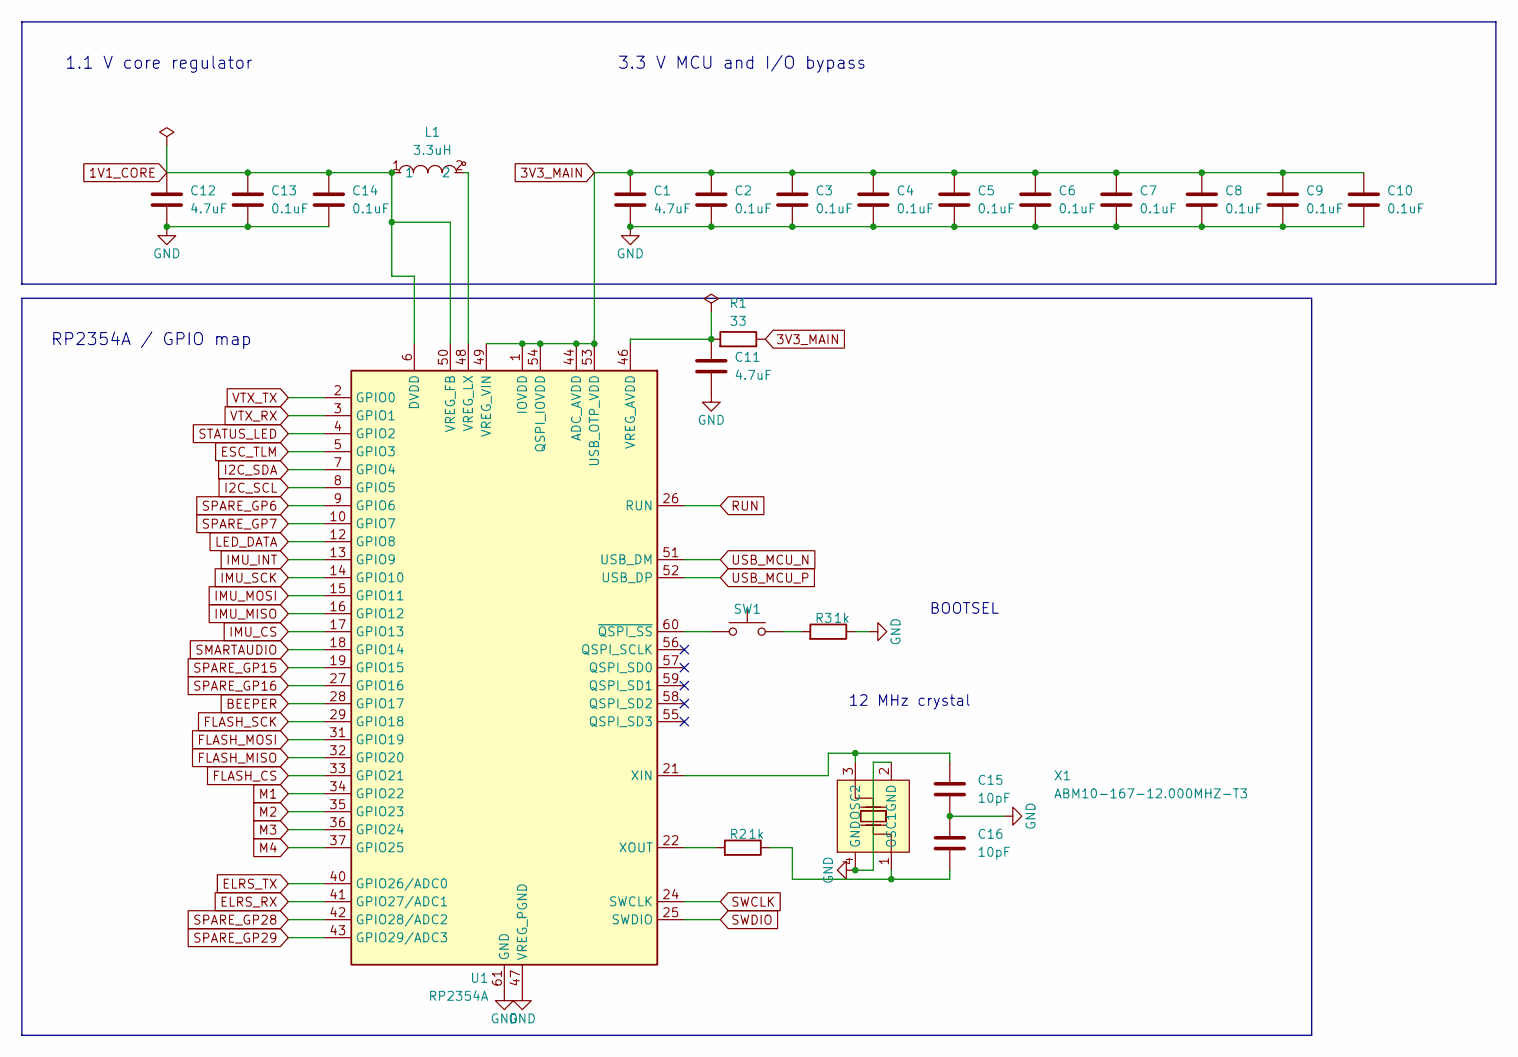
[picture p15: schematic mcu.kicad_sch, AERIX-20 - MCU and boot]

Parts:
C1, C11, C12: 4.7uF; C_0402_1005Metric
C2, C3, C4, C5, C6, C7, C8, C9, C10, C13, C14: 0.1uF; C_0402_1005Metric
C15, C16: 10pF; C_0402_1005Metric
L1: 3.3uH; IND-SMD_L2.0-W1.6_AOTA-B201610S3R3-101-T; MPN AOTA-B201610S3R3-101-T; LCSC Part C42411119
R1: 33; R_0402_1005Metric
R2, R3: 1k; R_0402_1005Metric
SW1: Momentary Tactile Button - Biege; Push_SMD_4.2x3.2mm_h2.5mm_Beige
U1: RP2354A; QFN-60-1EP_7x7mm_P0.4mm_EP3.4x3.4mm
X1: ABM10-167-12.000MHZ-T3; CRYSTAL-SMD_4P-L2.5-W2.0-BL; MPN ABM10-167-12.000MHZ-T3; LCSC Part C1985295

Connections:
1V1_CORE: C12.1, C13.1, C14.1, L1.1, U1.6 (DVDD), U1.23 (DVDD), U1.39 (DVDD), U1.50 (VREG_FB)
3V3_MAIN: C1.1, C2.1, C3.1, C4.1, C5.1, C6.1, C7.1, C8.1, C9.1, C10.1, R1.2, U1.1 (IOVDD), U1.11 (IOVDD), U1.20 (IOVDD), U1.30 (IOVDD), U1.38 (IOVDD), U1.44 (ADC_AVDD), U1.45 (IOVDD), U1.49 (VREG_VIN), U1.53 (USB_OTP_VDD), U1.54 (QSPI_IOVDD); also elsewhere on the board
BEEPER: U1.28 (GPIO17); also elsewhere on the board
ELRS_RX: U1.41 (GPIO27/ADC1); also elsewhere on the board
ELRS_TX: U1.40 (GPIO26/ADC0); also elsewhere on the board
ESC_TLM: U1.5 (GPIO3); also elsewhere on the board
FLASH_CS: U1.33 (GPIO21); also elsewhere on the board
FLASH_MISO: U1.32 (GPIO20); also elsewhere on the board
FLASH_MOSI: U1.31 (GPIO19); also elsewhere on the board
FLASH_SCK: U1.29 (GPIO18); also elsewhere on the board
GND: C1.2, C2.2, C3.2, C4.2, C5.2, C6.2, C7.2, C8.2, C9.2, C10.2, C11.2, C12.2, C13.2, C14.2, C15.2, C16.1, R3.2, U1.47 (VREG_PGND), U1.61 (GND), X1.2 (GND), X1.4 (GND); also elsewhere on the board
I2C_SCL: U1.8 (GPIO5); also elsewhere on the board
I2C_SDA: U1.7 (GPIO4); also elsewhere on the board
IMU_CS: U1.17 (GPIO13); also elsewhere on the board
IMU_INT: U1.13 (GPIO9); also elsewhere on the board
IMU_MISO: U1.16 (GPIO12); also elsewhere on the board
IMU_MOSI: U1.15 (GPIO11); also elsewhere on the board
IMU_SCK: U1.14 (GPIO10); also elsewhere on the board
LED_DATA: U1.12 (GPIO8); also elsewhere on the board
M1: U1.34 (GPIO22); also elsewhere on the board
M2: U1.35 (GPIO23); also elsewhere on the board
M3: U1.36 (GPIO24); also elsewhere on the board
M4: U1.37 (GPIO25); also elsewhere on the board
unnamed: R3.1, SW1.2
unnamed: C11.1, R1.1, U1.46 (VREG_AVDD)
unnamed: L1.2, U1.48 (VREG_LX)
unnamed: C15.1, U1.21 (XIN), X1.3 (OSC2)
unnamed: R2.1, U1.22 (XOUT)
unnamed: SW1.1, U1.60 (~QSPI_SS)
unnamed: C16.2, R2.2, X1.1 (OSC1)
RUN: U1.26 (RUN); also elsewhere on the board
SMARTAUDIO: U1.18 (GPIO14); also elsewhere on the board
SPARE_GP6: U1.9 (GPIO6)
SPARE_GP7: U1.10 (GPIO7)
SPARE_GP15: U1.19 (GPIO15)
SPARE_GP16: U1.27 (GPIO16)
SPARE_GP28: U1.42 (GPIO28/ADC2)
SPARE_GP29: U1.43 (GPIO29/ADC3)
STATUS_LED: U1.4 (GPIO2); also elsewhere on the board
SWCLK: U1.24 (SWCLK); also elsewhere on the board
SWDIO: U1.25 (SWDIO); also elsewhere on the board
USB_MCU_N: U1.51 (USB_DM); also elsewhere on the board
USB_MCU_P: U1.52 (USB_DP); also elsewhere on the board
VTX_RX: U1.3 (GPIO1); also elsewhere on the board
VTX_TX: U1.2 (GPIO0); also elsewhere on the board

Notes on the sheet:
1.1 V core regulator
12 MHz crystal
RP2354A / GPIO map
BOOTSEL
3.3 V MCU and I/O bypass

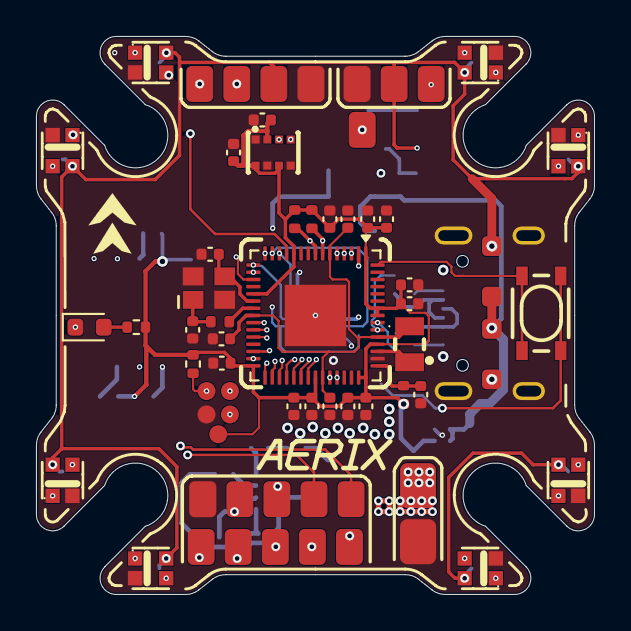
[picture p16: board fc-v1.kicad_pcb from above]

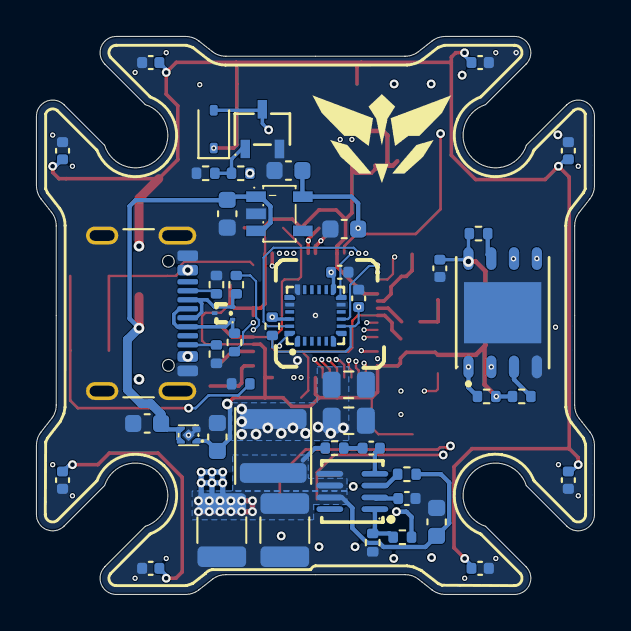
[picture p17: board fc-v1.kicad_pcb from below]

Board: 4 copper layers, 31.0 x 31.0 mm, 113 parts (48 on the bottom side), 67 nets.
