FBIopeningUPP/aerix-20x20/(commit log)

2026-11-09 staring out sahoor
    [etc.kicad_sch, fc-v1.kicad_pcb, fc-v1.kicad_sch, mcu.kicad_sch, power.kicad_sch, sensor.kicad_sch, signal.kicad_sch]
2026-11-09 staring out added mcu
    [etc.kicad_sch, fc-v1.kicad_pcb, mcu.kicad_sch, power.kicad_sch, sensor.kicad_sch, signal.kicad_sch]
2026-11-09 i am noob idk what to commiiit aaaaaaah
    [fc-v1.kicad_pcb, mcu.kicad_sch]
2026-11-09 langdi lulli
    [mcu.kicad_sch]
2026-11-09 added components and everything
    [etc.kicad_sch, fc-v1.kicad_pcb, mcu.kicad_sch, power.kicad_sch, sensor.kicad_sch, signal.kicad_sch]
2026-11-09 idk the shit ia m doing
    [etc.kicad_sch, fc-v1.kicad_pcb, fc-v1.kicad_sch, mcu.kicad_sch, power.kicad_sch, sensor.kicad_sch, signal.kicad_sch]
2026-11-09 schematic done lulu lemom
    [etc.kicad_sch, fc-v1.kicad_pcb, power.kicad_sch]
2026-11-09 layed out everything and all
    [fc-v1.kicad_pcb]
2026-11-09 giggity giggity
    [etc.kicad_sch, signal.kicad_sch]
2026-11-09 laying out
    [etc.kicad_sch, fc-v1.kicad_pcb]
2026-11-09 doing and doing shii
    [etc.kicad_sch, fc-v1.kicad_pcb, mcu.kicad_sch, power.kicad_sch, signal.kicad_sch]
2026-11-09 shit got riyal
    [etc.kicad_sch, fc-v1.kicad_pcb, mcu.kicad_sch, signal.kicad_sch]
2026-11-09 shitting around placing ws2812b
    [etc.kicad_sch, fc-v1.kicad_pcb]
2026-11-09 laiyed out
    [fc-v1.kicad_pcb]
2026-11-09 ckean up and all
    [etc.kicad_sch, fc-v1.kicad_pcb, fc-v1.kicad_sch, mcu.kicad_sch, power.kicad_sch, sensor.kicad_sch, signal.kicad_sch]
2026-11-09 cool af
    [fc-v1.kicad_pcb]
2026-11-09 nice and all
    [fc-v1.kicad_pcb]
2026-11-10 readme sahoor
    [aerix-bom.csv]
